maxmiztejm/SAR-APRS/Components/Parts from Ali.txt

Charging cable 5.5x2.5 https://ru.aliexpress.com/item/USB-2-0-DC-5-5-2-5-5-5-2-5-5-5x2-5-Tubular/32855133449.html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
Tranciever DRA818V https://ru.aliexpress.com/item/144MHz-145MHz-146MHz-154MHz-174MHz-VHF-HAM-Radio-Module-Amateur-Radio-DRA818V/32808904547.html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
SMA pigtail https://ru.aliexpress.com/item/10pcs-pack-Free-shipping-SMA-head-extension-cable-antenna-tieline-with-female-SMA-head/32610948819.html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
Battery case 18650x2 https://ru.aliexpress.com/item/16850-Battery-Case-Storage-Box-Case-Plastic-Holder-With-Wire-Leads-for-2-x-18650-Batteries/32510243073.html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
DC power socket 5.5x2.5 https://ru.aliexpress.com/item/10PCS-DC-power-socket-DC022-receptacle-dustproof-cap-DC-022-5-5X2-5mm-with-waterproof-cap/32339224930.html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
