maxmiztejm/SAR-APRS/HW/SAR-APRS/sar_aprs_V2.pdf

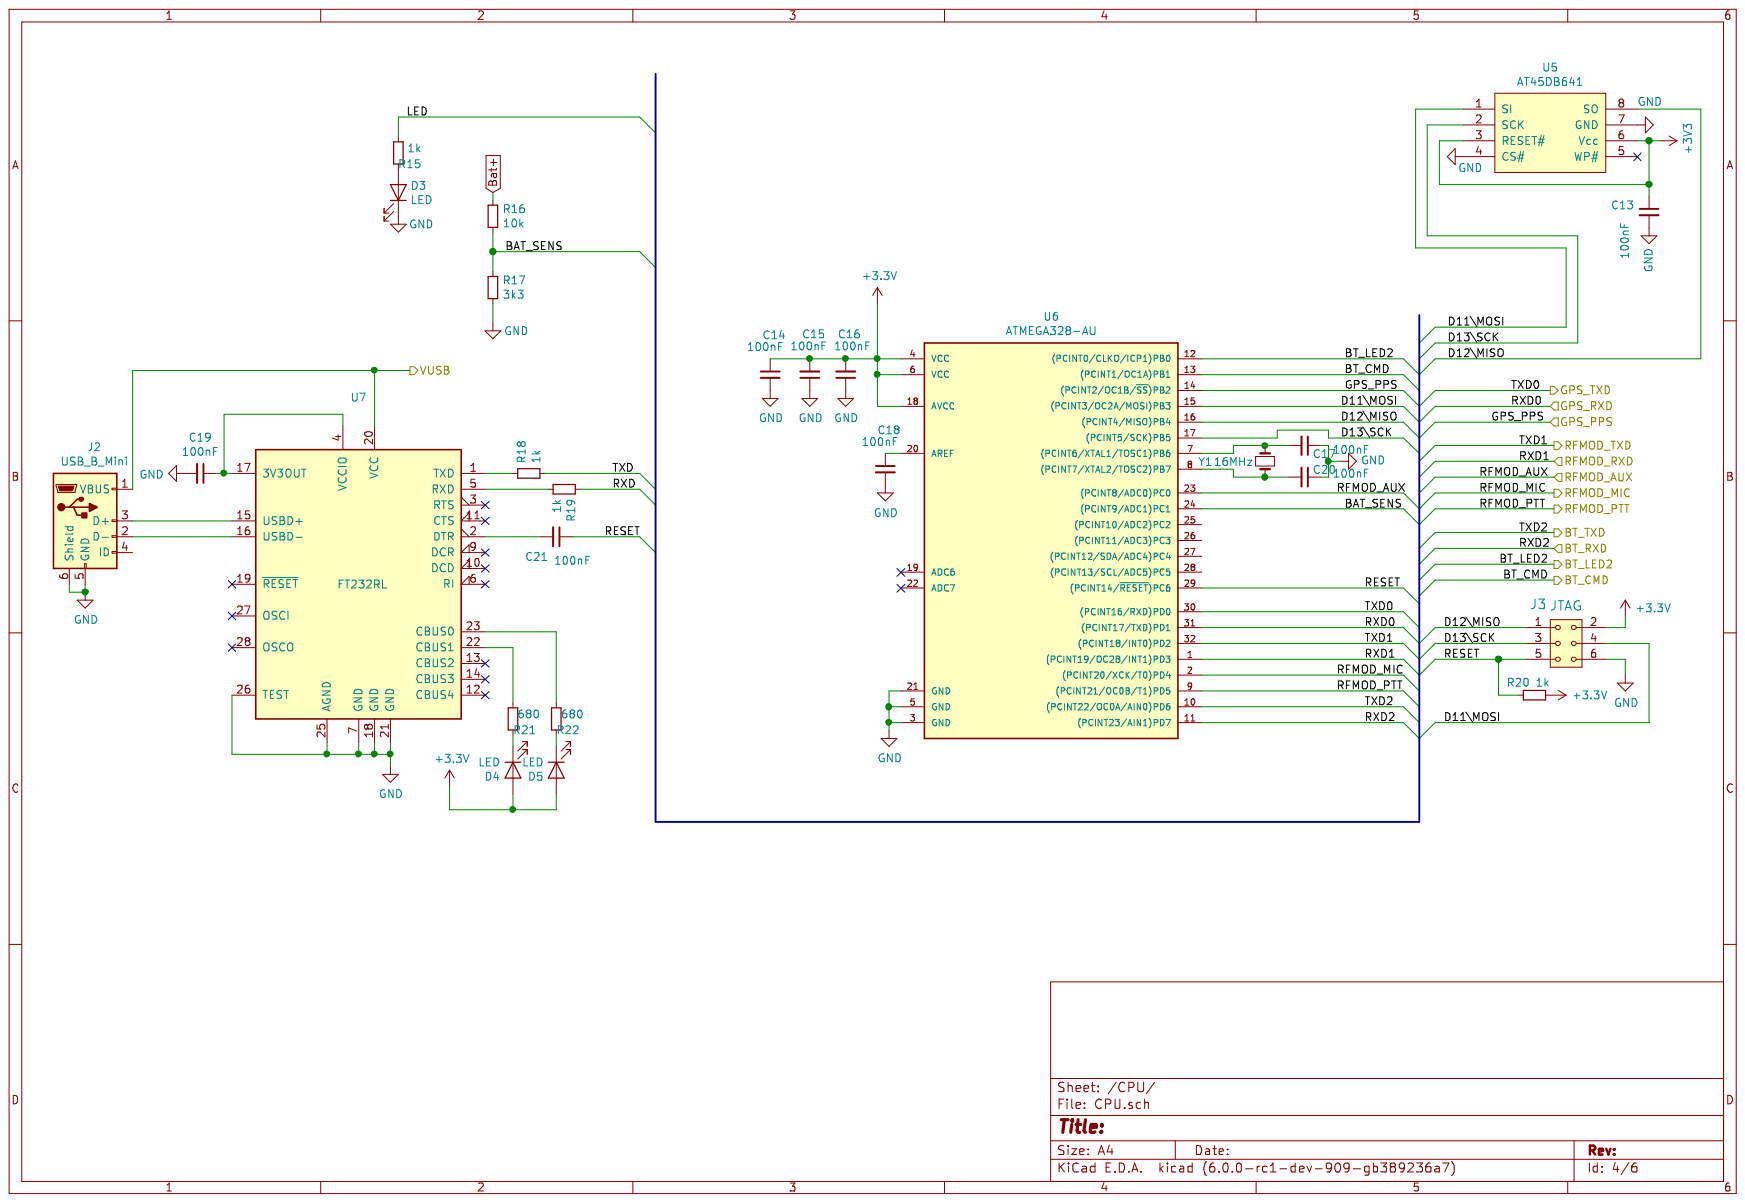
[picture p13: page 4]
