maxmiztejm/SAR-APRS/HW/SAR-APRS/sar_aprs.pdf

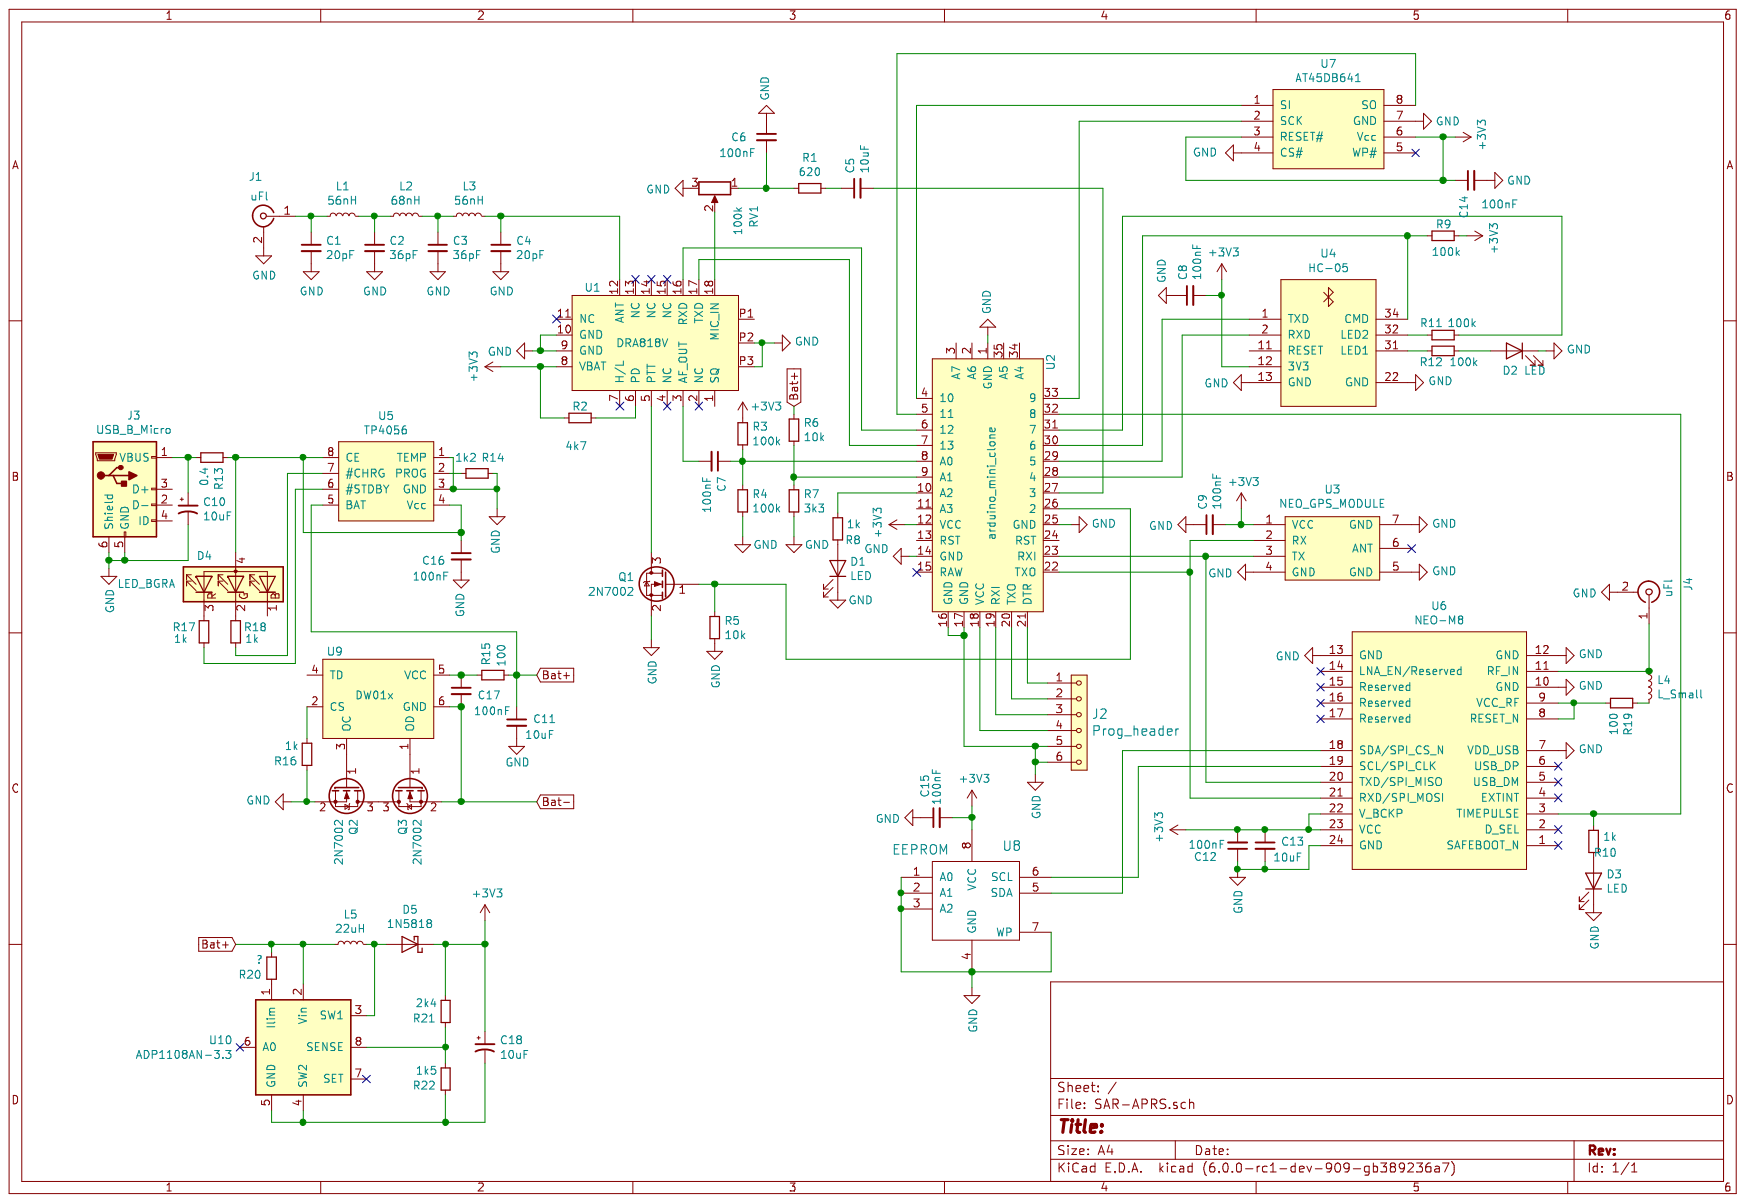
[picture p14: page 1]
