maxmiztejm/SAR-APRS/HW/SAR-APRS/SAR-APRS.kicad_pcb

## KiCad design HW/SAR-APRS/SAR-APRS.kicad_pcb (2020-05-20)

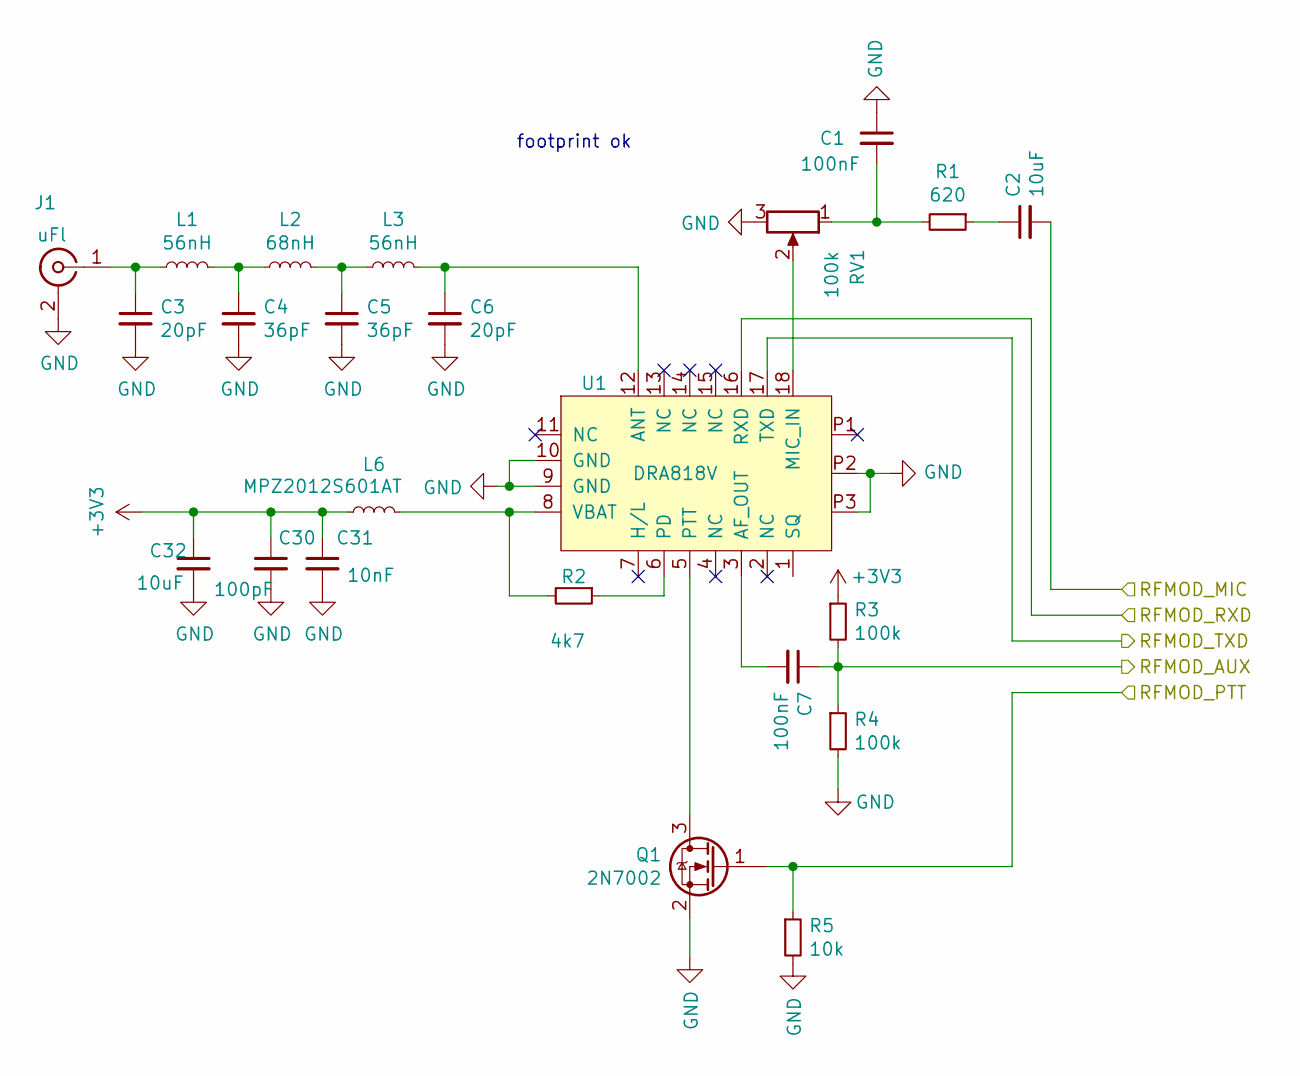
[picture p15: schematic RF_MODULE.sch]

Parts:
C1, C7: 100nF; C_0805
C2: 10uF; C_0805
C3, C6: 20pF; C_0805
C4, C5: 36pF; C_0805
C30: 100pF; C_0603
C31: 10nF; C_0603
C32: 10uF; C_1210
J1: uFl; sma_straight_32k101-400l5
L1, L3: 56nH; L_0805
L2: 68nH; L_0805
L6: MPZ2012S601AT; C_0805
Q1: 2N7002; SOT-23
R1: 620; R_0805
R2: 4k7; R_0805
R3, R4: 100k; R_0805
R5: 10k; R_0805
RV1: 100k; Potentiometer_Trimmer_Bourns_3214J
U1: DRA818V; DRA818

Connections:
/CPU/RFMOD_AUX: C7.1, R3.2, R4.1; also elsewhere on the board
/CPU/RFMOD_MIC: C2.2; also elsewhere on the board
/CPU/RFMOD_PTT: Q1.1 (G), R5.1; also elsewhere on the board
/CPU/RFMOD_RXD: U1.16 (RXD); also elsewhere on the board
/CPU/RFMOD_TXD: U1.17 (TXD); also elsewhere on the board
GND: C1.1, C3.2, C4.2, C5.2, C6.2, C30.2, C31.2, C32.2, J1.2 (Ext), Q1.2 (S), R4.2, R5.2, RV1.3, U1.9 (GND), U1.10 (GND), U1.P2, U1.P3; also elsewhere on the board
unnamed: C1.2, R1.2, RV1.1
unnamed: C2.1, R1.1
unnamed: C3.1, J1.1 (In), L1.1
unnamed: C4.1, L1.2, L2.1
unnamed: C5.1, L2.2, L3.1
unnamed: C6.1, L3.2, U1.12 (ANT)
unnamed: C7.2, U1.3 (AF_OUT)
unnamed: L6.2, R2.2, U1.8 (VBAT)
unnamed: Q1.3 (D), U1.5 (PTT)
unnamed: R2.1, U1.6 (PD)
unnamed: RV1.2, U1.18 (MIC_IN)

Notes on the sheet:
footprint ok

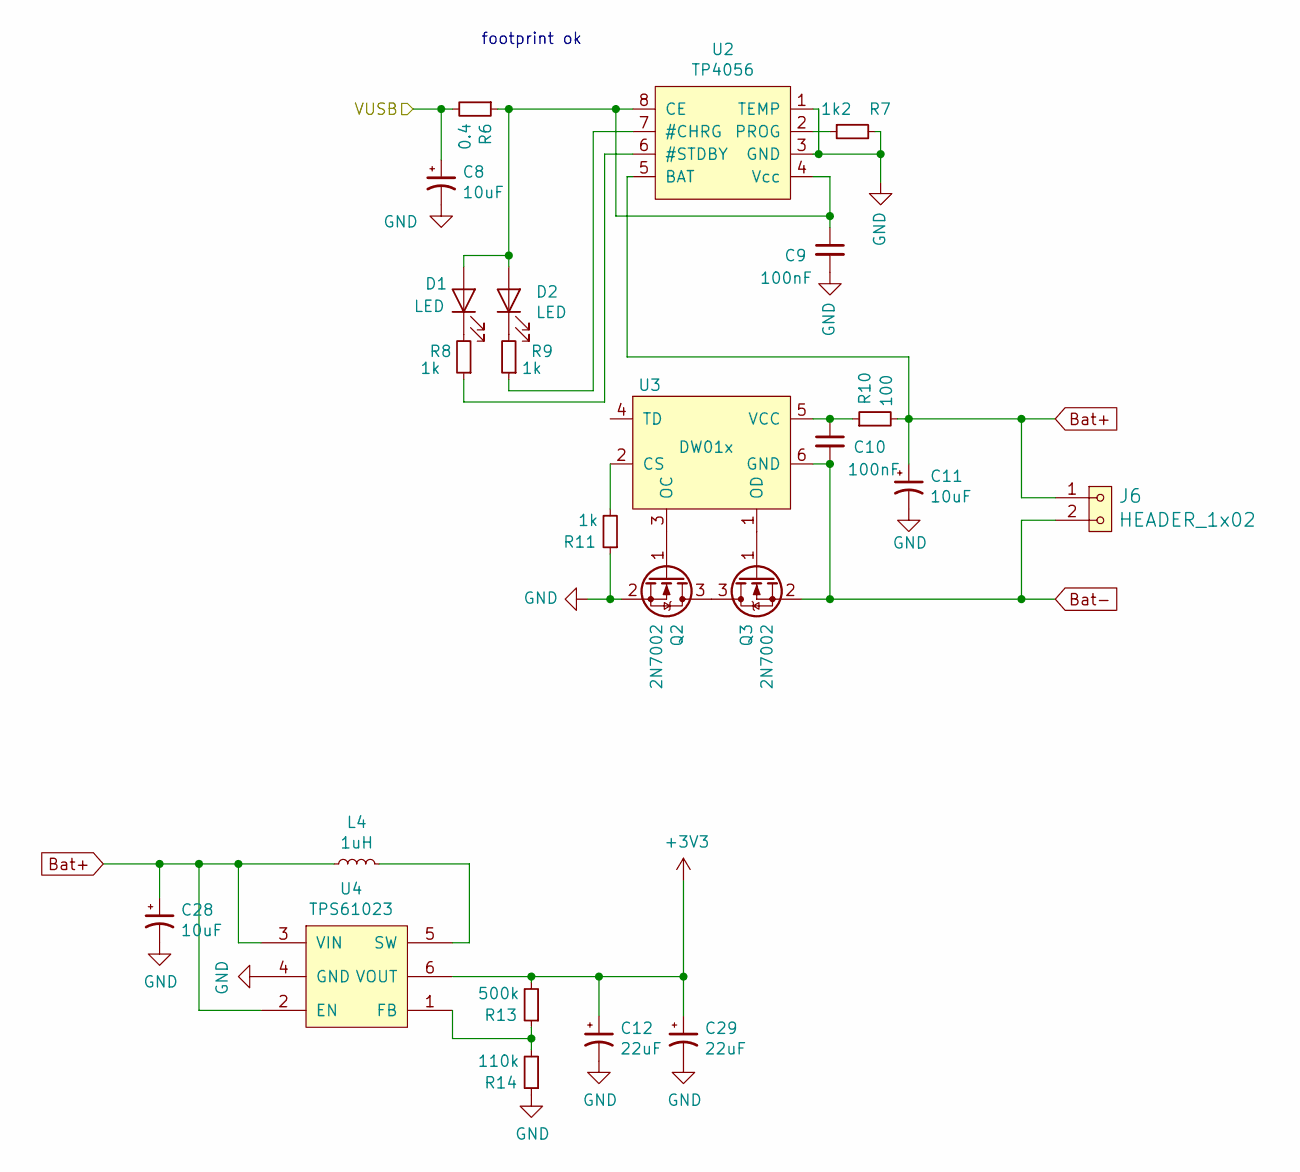
[picture p16: schematic Power.sch]

Parts:
C8, C11, C28: 10uF; C_1210
C9, C10: 100nF; C_0805
C12, C29: 22uF; C_1210
D1, D2: LED; LED_0805
J6: HEADER_1x02; Straight_1x02
L4: 1uH; L_6.3x6.3_H3
Q2, Q3: 2N7002; SOT-23
R6: 0.4; R_2512
R7: 1k2; R_0805
R8, R9, R11: 1k; R_0805
R10: 100; R_0805
R13: 500k; R_0805
R14: 110k; R_0805
U2: TP4056; SO-8_3.9x4.9mm_P1.27mm
U3: DW01x; SOT-23-6
U4: TPS61023; SOT-563

Connections:
/CPU/VUSB: C8.1, R6.2; also elsewhere on the board
Bat+: C11.1, C28.1, J6.1, L4.1, R10.2, U2.5 (BAT), U4.2 (EN), U4.3 (VIN); also elsewhere on the board
Bat-: C10.2, J6.2, Q3.2 (S), U3.6 (GND)
GND: C8.2, C9.2, C11.2, C12.2, C28.2, C29.2, Q2.2 (S), R7.2, R11.1, R14.1, U2.1 (TEMP), U2.3 (GND), U4.4 (GND); also elsewhere on the board
unnamed: C9.1, D1.2 (A), D2.2 (A), R6.1, U2.4 (Vcc), U2.8 (CE)
unnamed: C10.1, R10.1, U3.5 (VCC)
unnamed: D1.1 (K), R8.2
unnamed: D2.1 (K), R9.2
unnamed: L4.2, U4.5 (SW)
unnamed: Q2.1 (G), U3.3 (OC)
unnamed: Q2.3 (D), Q3.3 (D)
unnamed: Q3.1 (G), U3.1 (OD)
unnamed: R7.1, U2.2 (PROG)
unnamed: R8.1, U2.6 (#STDBY)
unnamed: R9.1, U2.7 (#CHRG)
unnamed: R11.2, U3.2 (CS)
unnamed: R13.1, R14.2, U4.1 (FB)

Notes on the sheet:
footprint ok

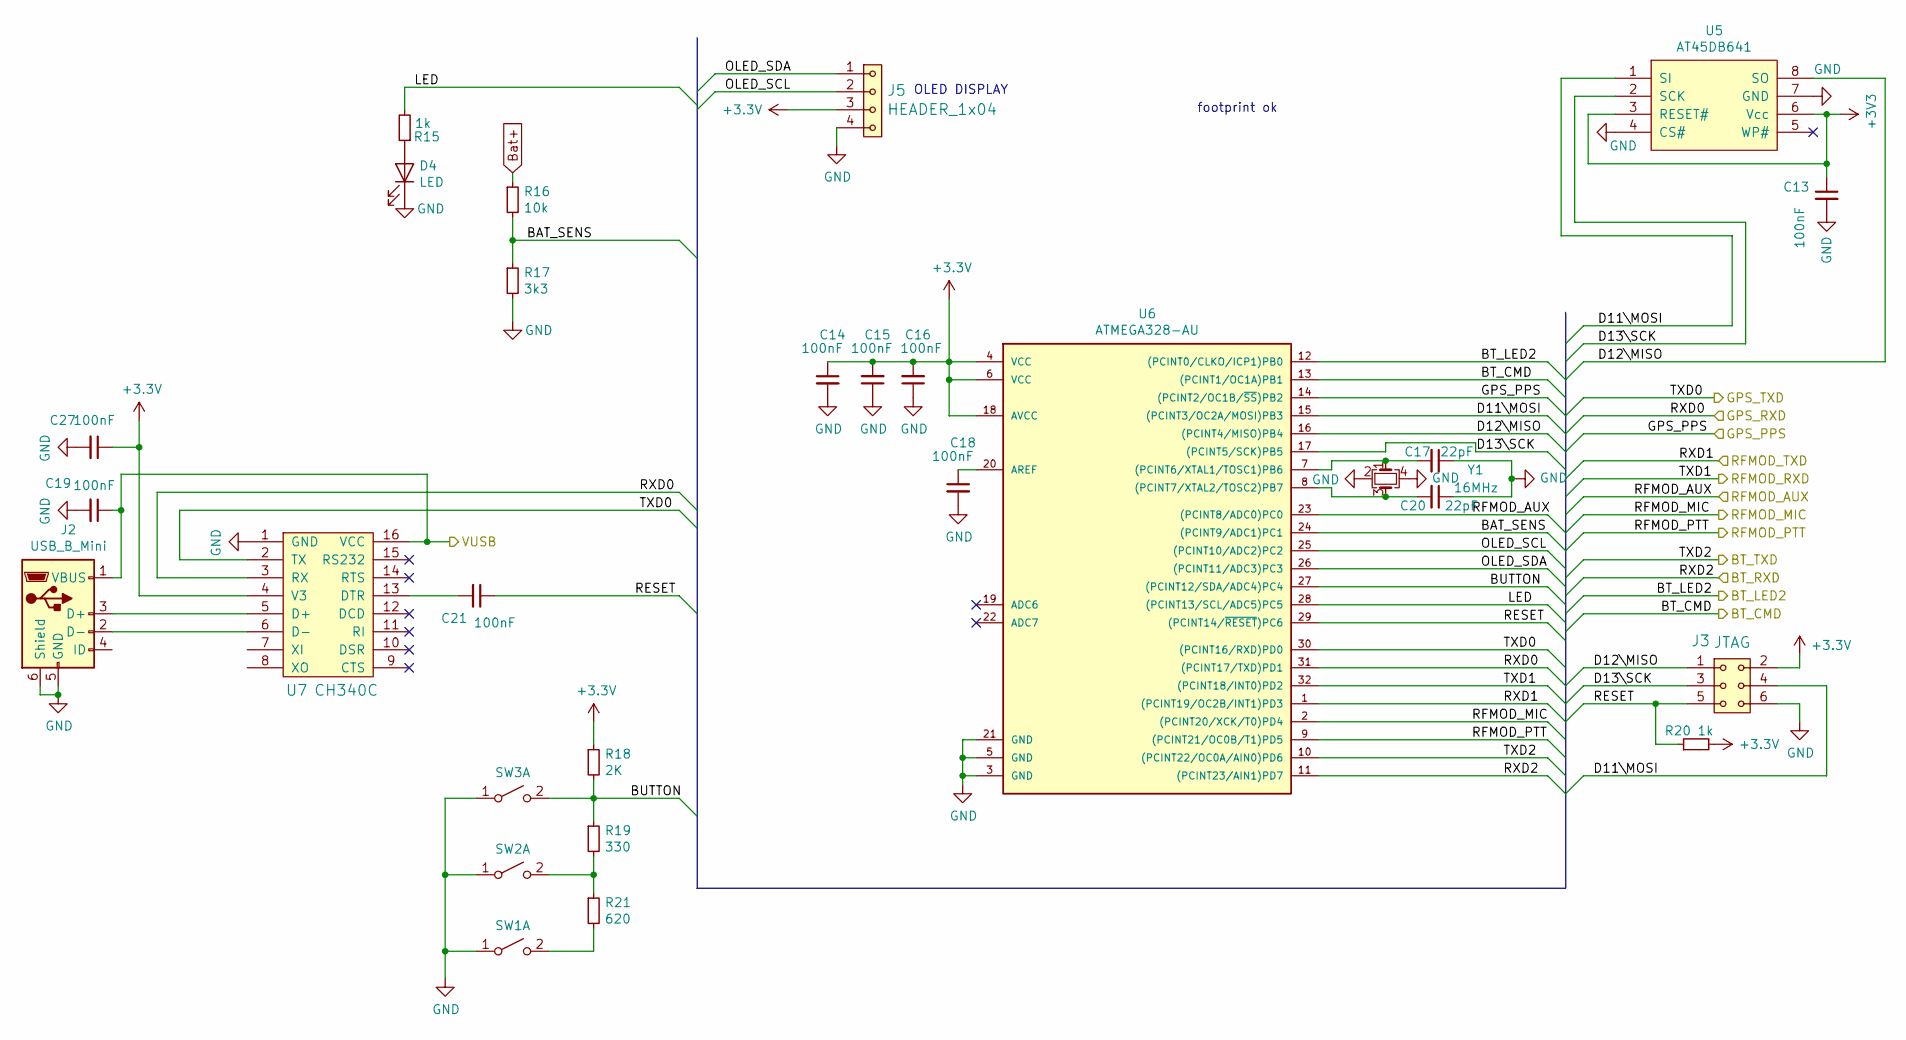
[picture p17: schematic CPU.sch]

Parts:
C13, C14, C15, C16, C18, C19, C21, C27: 100nF; C_0805
C17, C20: 22pF; C_0805
D4: LED; LED_0805
J2: USB_B_Mini; USB_Mini-B
J3: JTAG; Straight_2x03
J5: HEADER_1x04; Straight_1x04
R15, R20: 1k; R_0805
R16: 10k; R_0805
R17: 3k3; R_0805
R18: 2K; R_0805
R19: 330; R_0805
R21: 620; R_0805
SW1, SW2, SW3: SW_DPST_x2; SW_SPST_EVQP0
U5: AT45DB641; SOIC-8_3.9x4.9mm_Pitch1.27mm
U6: ATMEGA328-AU; TQFP-32_7x7mm_Pitch0.8mm
U7: CH340C; SOP-16_4.55x10.3mm_P1.27mm
Y1: 16MHz; ISM81

Connections:
/BT_module/BT_CMD: U6.13 ((PCINT1/OC1A)PB1); also elsewhere on the board
/BT_module/BT_LED2: U6.12 ((PCINT0/CLKO/ICP1)PB0); also elsewhere on the board
/BT_module/BT_RXD: U6.11 ((PCINT23/AIN1)PD7); also elsewhere on the board
/BT_module/BT_TXD: U6.10 ((PCINT22/OC0A/AIN0)PD6); also elsewhere on the board
/CPU/BAT_SENS: R16.2, R17.1, U6.24 ((PCINT9/ADC1)PC1)
/CPU/BUTTON: R18.2, R19.1, SW3.2 (B), U6.27 ((PCINT12/SDA/ADC4)PC4)
/CPU/D11\MOSI: J3.4, U5.1 (SI), U6.15 ((PCINT3/OC2A/MOSI)PB3)
/CPU/D12\MISO: J3.1, U5.8 (SO), U6.16 ((PCINT4/MISO)PB4)
/CPU/D13\SCK: J3.3, U5.2 (SCK), U6.17 ((PCINT5/SCK)PB5)
/CPU/GPS_PPS: U6.14 ((PCINT2/OC1B/~SS~)PB2); also elsewhere on the board
/CPU/GPS_RXD: U6.31 ((PCINT17/TXD)PD1), U7.3 (RX); also elsewhere on the board
/CPU/LED: R15.2, U6.28 ((PCINT13/SCL/ADC5)PC5)
/CPU/OLED_SCL: J5.2, U6.25 ((PCINT10/ADC2)PC2)
/CPU/OLED_SDA: J5.1, U6.26 ((PCINT11/ADC3)PC3)
/CPU/RESET: C21.1, J3.5, R20.1, U6.29 ((PCINT14/~RESET~)PC6)
/CPU/RFMOD_AUX: U6.23 ((PCINT8/ADC0)PC0); also elsewhere on the board
/CPU/RFMOD_MIC: U6.2 ((PCINT20/XCK/T0)PD4); also elsewhere on the board
/CPU/RFMOD_PTT: U6.9 ((PCINT21/OC0B/T1)PD5); also elsewhere on the board
/CPU/RFMOD_RXD: U6.32 ((PCINT18/INT0)PD2); also elsewhere on the board
/CPU/RFMOD_TXD: U6.1 ((PCINT19/OC2B/INT1)PD3); also elsewhere on the board
/CPU/VUSB: C19.1, J2.1 (VBUS), U7.16 (VCC); also elsewhere on the board
/GPS/GPS_RXD: U6.30 ((PCINT16/RXD)PD0), U7.2 (TX); also elsewhere on the board
Bat+: R16.1; also elsewhere on the board
GND: C13.2, C14.2, C15.1, C16.1, C17.1, C18.2, C19.2, C20.1, C27.2, D4.1 (K), J2.5 (GND), J2.6 (Shield), J3.6, J5.4, R17.2, SW1.1 (A), SW2.1 (A), SW3.1 (A), U5.4 (CS#), U5.7 (GND), U6.3 (GND), U6.5 (GND), U6.21 (GND), U7.1 (GND), Y1.2, Y1.4; also elsewhere on the board
unnamed: C17.2, U6.7 ((PCINT6/XTAL1/TOSC1)PB6), Y1.1
unnamed: C18.1, U6.20 (AREF)
unnamed: C20.2, U6.8 ((PCINT7/XTAL2/TOSC2)PB7), Y1.3
unnamed: C21.2, U7.13 (DTR)
unnamed: D4.2 (A), R15.1
unnamed: J2.2 (D-), U7.6 (D-)
unnamed: J2.3 (D+), U7.5 (D+)
unnamed: R19.2, R21.1, SW2.2 (B)
unnamed: R21.2, SW1.2 (B)

Notes on the sheet:
OLED DISPLAY
footprint ok

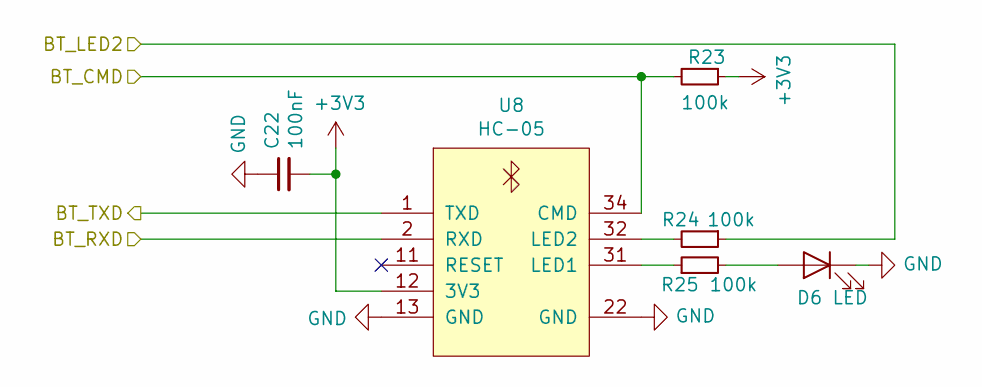
[picture p18: schematic BT_module.sch]

Parts:
C22: 100nF; C_0805
D6: LED; LED_0805
R23, R24, R25: 100k; R_0805
U8: HC-05; HC-05 BT

Connections:
/BT_module/BT_CMD: R23.2, U8.34 (CMD); also elsewhere on the board
/BT_module/BT_LED2: R24.1; also elsewhere on the board
/BT_module/BT_RXD: U8.2 (RXD); also elsewhere on the board
/BT_module/BT_TXD: U8.1 (TXD); also elsewhere on the board
GND: C22.1, D6.1 (K), U8.13 (GND), U8.22 (GND); also elsewhere on the board
unnamed: D6.2 (A), R25.2
unnamed: R24.2, U8.32 (LED2)
unnamed: R25.1, U8.31 (LED1)

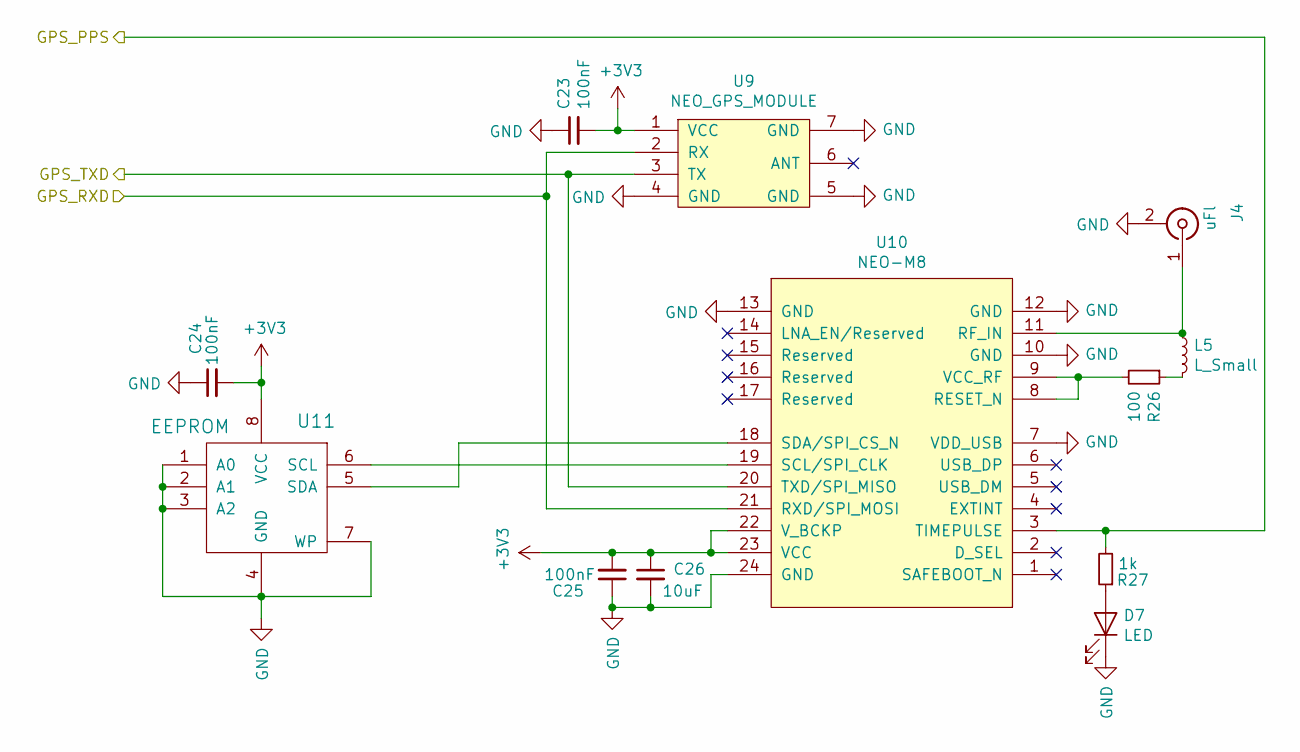
[picture p19: schematic GPS.sch]

Parts:
C23, C24, C25: 100nF; C_0805
C26: 10uF; C_1210
D7: LED; LED_0805
J4: uFl; coaxial_u.fl-r-smt-1
L5: L_Small; L_0805
R26: 100; R_0805
R27: 1k; R_0805
U9: NEO_GPS_MODULE; Straight_1x04
U10: NEO-M8; ublox_NEO
U11: EEPROM; TSSOP-8_4.4x3mm_P0.65mm

Connections:
/CPU/GPS_PPS: R27.2, U10.3 (TIMEPULSE); also elsewhere on the board
/CPU/GPS_RXD: U9.3 (TX), U10.20 (TXD/SPI_MISO); also elsewhere on the board
/GPS/GPS_RXD: U9.2 (RX), U10.21 (RXD/SPI_MOSI); also elsewhere on the board
GND: C23.1, C24.1, C25.1, C26.2, D7.1 (K), J4.2 (Ext), U9.4 (GND), U9.5 (GND), U9.7 (GND), U10.7 (VDD_USB), U10.10 (GND), U10.12 (GND), U10.13 (GND), U10.24 (GND), U11.1 (A0), U11.2 (A1), U11.3 (A2), U11.4 (GND), U11.7 (WP); also elsewhere on the board
unnamed: D7.2 (A), R27.1
unnamed: J4.1 (In), L5.1, U10.11 (RF_IN)
unnamed: L5.2, R26.1
unnamed: R26.2, U10.8 (RESET_N), U10.9 (VCC_RF)
unnamed: U10.18 (SDA/SPI_CS_N), U11.5 (SDA)
unnamed: U10.19 (SCL/SPI_CLK), U11.6 (SCL)

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
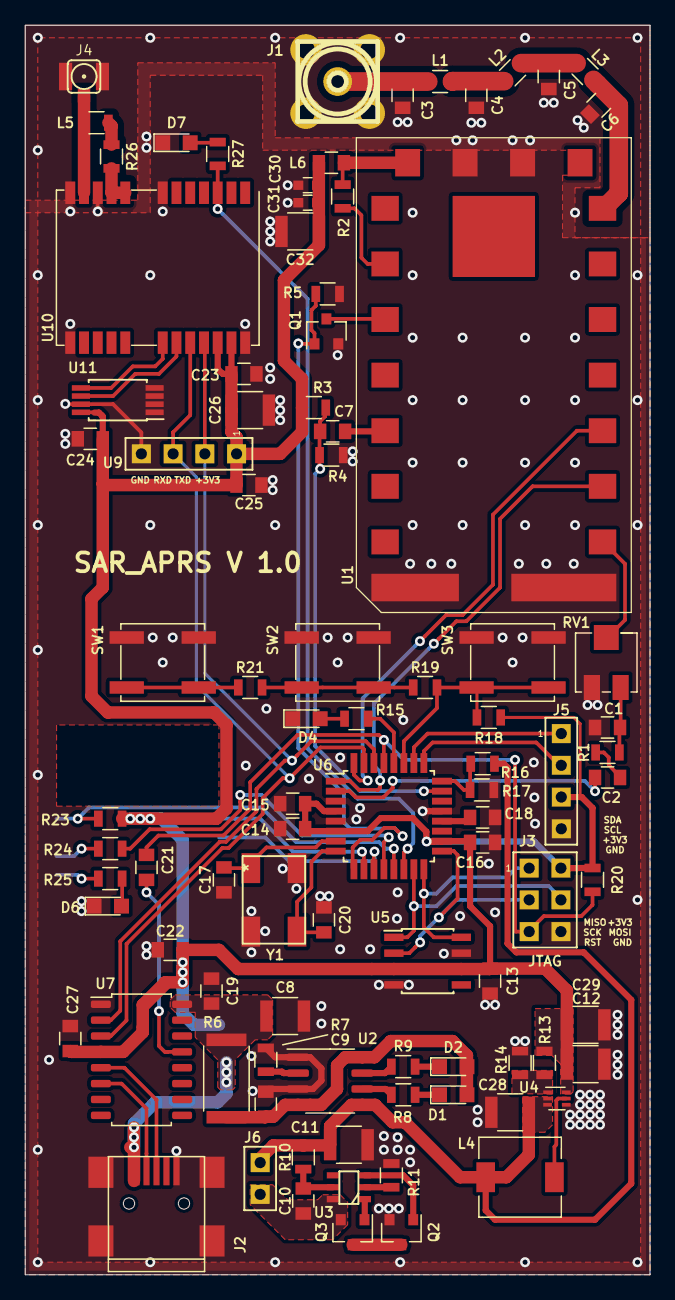
[picture p20: board SAR-APRS.kicad_pcb from above]

Board: 2 copper layers, 50.0 x 100.0 mm, 93 parts (1 on the bottom side), 68 nets.
