maxmiztejm/SAR-APRS/Firmware/buzzer_avr.cpp

/* trackuino copyright (C) 2010  EA5HAV Javi
 *
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
 * You should have received a copy of the GNU General Public License
 * along with this program; if not, write to the Free Software
 * Foundation, Inc., 51 Franklin Street, Fifth Floor, Boston, MA  02110-1301, USA.
 */
 /*
#ifdef AVR

#include "config.h"
#include "buzzer.h"
#include "pin.h"
#if (ARDUINO + 1) >= 100
#  include <Arduino.h>
#else
#  include <WProgram.h>
#endif
#include <stdint.h>
#include <avr/interrupt.h>
#include <avr/io.h>


// Module constants
static const unsigned long PWM_PERIOD = F_CPU / BUZZER_FREQ;
static const unsigned long ON_CYCLES = BUZZER_FREQ * BUZZER_ON_TIME;
static const unsigned long OFF_CYCLES = BUZZER_FREQ * BUZZER_OFF_TIME;
#if BUZZER_TYPE == 0  // active buzzer
static const uint16_t DUTY_CYCLE = PWM_PERIOD;
#endif
#if BUZZER_TYPE == 1  // passive buzzer
static const uint16_t DUTY_CYCLE = PWM_PERIOD / 2;
#endif

// Module variables
static volatile bool is_buzzer_on;
static volatile bool buzzing;
static volatile unsigned long alarm;

// Exported functions
void buzzer_setup()
{
  pinMode(BUZZER_PIN, OUTPUT);
  pin_write(BUZZER_PIN, LOW);
  buzzing = false;
  is_buzzer_on = false;
  alarm = 1;

  // Top is ICR1 (WGM1=14), p.135
  TCCR1A = _BV(WGM11);
  TCCR1B = _BV(WGM13) | _BV(WGM12);

  // Set top to PWM_PERIOD
  ICR1 = PWM_PERIOD;

  // Enable interrupts on timer overflow
  TIMSK1 |= _BV(TOIE1);

  // Start the timer, no prescaler (CS1=1)
  TCCR1B |= _BV(CS10);
}

void buzzer_on()
{
  is_buzzer_on = true;
}

void buzzer_off()
{
  is_buzzer_on = false;
}

// Interrupt Service Routine for TIMER1. This is used to switch between the
// buzzing and quiet periods when ON_CYCLES or OFF_CYCLES are reached.
ISR (TIMER1_OVF_vect)
{
  interrupts();    // allow other interrupts (ie. modem)
  alarm--;
  if (alarm == 0) {
    buzzing = !buzzing;
    if (is_buzzer_on && buzzing) {
      switch(BUZZER_PIN) {
        case 9:
          // Non-inverting pin 9 (COM1A=2), p.135
          TCCR1A |= _BV(COM1A1);
          OCR1A = DUTY_CYCLE;
          break;
        case 10:
          // Non-inverting pin 10 (COM1B=2), p.135
          TCCR1A |= _BV(COM1B1);
          OCR1B = DUTY_CYCLE;
          break;
      }
      alarm = ON_CYCLES;
    } else {
      switch(BUZZER_PIN) {
        // Disable PWM on pin 9/10
        case 9:  TCCR1A &= ~_BV(COM1A1); break;
        case 10: TCCR1A &= ~_BV(COM1B1); break;
      }
      pin_write(BUZZER_PIN, LOW);
      alarm = OFF_CYCLES;
    }
  }
}

#endif // #ifdef AVR
*/
