maxmiztejm/SAR-APRS/(commit log)

2018-11-23 schematic update
    [SAR-APRS.sch]
2018-12-15 schematic update memmory adding
    [SAR-APRS.kicad_pcb, SAR-APRS.sch]
2019-03-29 schem and pcb update
    [BT_module.sch, CPU.sch, GPS.sch, Power.sch, RF_MODULE.sch, SAR-APRS.kicad_pcb, SAR-APRS.sch]
2019-03-31 schm and pcb update
    [BT_module.sch, CPU.sch, GPS.sch, Power.sch, SAR-APRS.kicad_pcb]
2019-04-23 PCB update
    [BT_module.sch, CPU.sch, GPS.sch, Power.sch, RF_MODULE.sch, SAR-APRS.kicad_pcb, SAR-APRS.sch]
2020-02-24 adding gerbers and bom
    [SAR-APRS-B_Cu.gbr, SAR-APRS-B_Mask.gbr, SAR-APRS-B_SilkS.gbr, SAR-APRS-Edge_Cuts.gbr, SAR-APRS-F_Cu.gbr, SAR-APRS-F_Mask.gbr, SAR-APRS-F_SilkS.gbr, SAR-APRS-NPTH.drl]
2020-03-08 DC-DC changed, PCB update
    [GPS.sch, RF_MODULE.sch, SAR-APRS.kicad_pcb, SAR-APRS_nightly.kicad_pcb]
2020-03-15 ibom added
    [Power.sch, RF_MODULE.sch, SAR-APRS.kicad_pcb]
2020-05-20 gerbers update
    [SAR-APRS-B_Cu.gbr, SAR-APRS-B_Mask.gbr, SAR-APRS-B_Paste.gbr, SAR-APRS-B_SilkS.gbr, SAR-APRS-Edge_Cuts.gbr, SAR-APRS-F_Cu.gbr, SAR-APRS-F_Paste.gbr, SAR-APRS-F_SilkS.gbr]
