maxmiztejm/SAR-APRS/(notices)

Notices in the files:
Firmware/afsk.cpp:
modify it under the terms of the GNU General Public License
